Frosthaven/zmk-config-corne-eclipse/README.md

README | [Keymap](KEYMAP.md) | [Parts](PARTS.md) | [Fabrication](FABRICATION.md) | [Building](BUILDING.md) | [Tricks](TRICKS.md)

# Corne Eclipse

Corne Eclipse Front And Back

The Corne Eclipse is a highly customized wireless Corne MX with the following:

- Custom circuit board design
    - JST port with line passthrough for undercarriage battery storage
    - Native support for nice!view displays
    - Native support for dual EC11 encoders
    - Native support for side mounted power switches
    - Native support for tenting puck
- Custom shield casing design (based on Void's case)
    - Undercarriage battery storage
    - Optimized material usage for bottom
    - Native support for tenting puck

*This was a project I finished in 2021. Finally updated and open sourced!*
