Frosthaven/zmk-config-corne-eclipse/assets/images/mac-rebind-modifiers.png

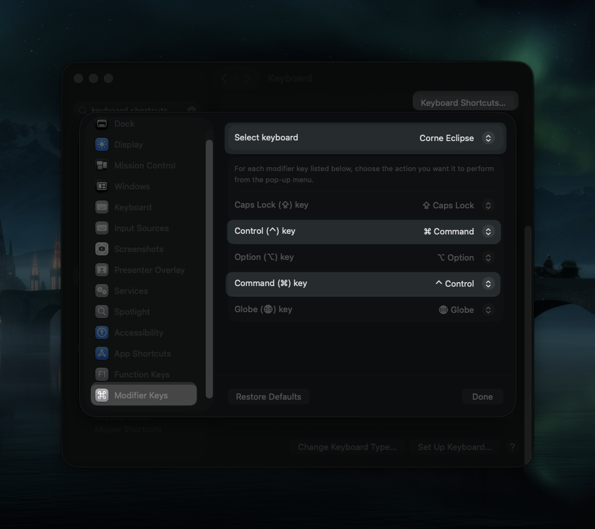
assets/images/mac-rebind-modifiers.png
