Frosthaven/zmk-config-corne-eclipse/fabrication/!for-fabricator-production/corne-eclipse-shield-right.stl

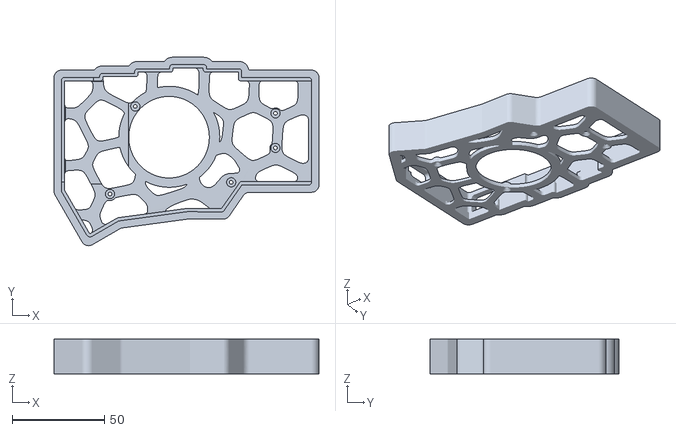
[picture p9: CAD file, 2026-03-28]
fabrication/!for-fabricator-production/corne-eclipse-shield-right.stl
143.7 x 102.3 x 18.9
