Frosthaven/zmk-config-corne-eclipse/(list of files, cad)

Other CAD files:
fabrication/!for-fabricator-production/corne-eclipse-shield-left.stl
