Frosthaven/zmk-config-corne-eclipse/FABRICATION.md

[README](README.md) | [Keymap](KEYMAP.md) | [Parts](PARTS.md) | Fabrication | [Building](BUILDING.md) | [Tricks](TRICKS.md)

# Fabrication

While the [parts](PARTS.md) page covers items you can buy, this page documents
what needs to be created.

The circuit board, plates, and shields need to be fabricated by a PCB and 3D
printing company like [Elecrow](https://www.elecrow.com/),
[JLCPCB](https://jlcpcb.com/), [PCBWay](https://www.pcbway.com/), or
[OSHPark](https://oshpark.com/). I've had good work from Elecrow in the past.

## Circuit Board Fabrication

### Circuit Board

Circuit Board

Some vendors won't render the outside negative space of the circuitboard
correctly in their uploader tool, but it is still fine.

Provide these files to the fabricator:
- [corne-eclipse-circuitboard.zip](/fabrication/!for-fabricator-production/corne-eclipse-circuitboard.zip)

### Plates

Plates

This will need to be cut the same way that circuitboards are. There may be an
extra charge for adding break-away points to the plate print.

Provide these files to the fabricator:
- [corne-eclipse-plates.zip](/fabrication/!for-fabricator-production/corne-eclipse-plates.zip)

## Shield Case Fabrication

Shield

Provide these files to the fabricator:
- [corne-eclipse-shield-left.stl](/fabrication/!for-fabricator-production/corne-eclipse-shield-left.stl)
- [corne-eclipse-shield-right.stl](/fabrication/!for-fabricator-production/corne-eclipse-shield-right.stl)
