Frosthaven/zmk-config-corne-eclipse/BUILDING.md

[README](README.md) | [Keymap](KEYMAP.md) | [Parts](PARTS.md) | [Fabrication](FABRICATION.md) | Building | [Tricks](TRICKS.md)

# Building

Coming Soon
