Frosthaven/zmk-config-corne-eclipse/(commit log)

2026-03-28 Import project
    [corne-eclipse-B_Cu.gbl, corne-eclipse-B_Mask.gbs, corne-eclipse-B_Silkscreen.gbo, corne-eclipse-Edge_Cuts.gm1, corne-eclipse-F_Cu.gtl, corne-eclipse-F_Mask.gts, corne-eclipse-F_Silkscreen.gto, corne-eclipse-NPTH-drl_map.gbr]
2026-03-28 chore: rework NAVPAD layer navigation keys
    Remove cross-platform line start/end macros in favor of plain Home/End
    keys. Reorganize nav cluster: Home/End replace macros, PgUp/PgDn shift
    inward, add PrintScreen/Insert/PauseBreak, swap NumLock/ScrollLock.
2026-03-29 refactor(keymap): reorganize layers 5-7
    - Rename layers: SYMBOL→NAVSYM, NAVPAD→MSENUM
    - Move nav keys to NAVSYM, mouse/media to MSENUM, F-keys to SYSTEM
    - Move brightness controls to SYSTEM layer
    - Add media controls (prev/play/next) to NAVSYM
    - Move middle click below mouse down on MSENUM
2026-05-20 feat(widgets): show ".." on battery cells while settling at boot
2026-05-23 docs(trackpad): note 3V3 as an alias for the VCC/VDD power pad
2026-05-24 feat(trackpad): port updated input-split gesture firmware to main
    Bring the peripheral-trackpad input-split architecture + forked gesture driver
    to main (overlays, dtsi, west.yml driver pin, central-status widgets, scenario
    build variants for all 5 layouts, release workflow, wiring doc). main's old
    USE_TRACKPAD/direct-listener scheme couldn't support a peripheral-side trackpad.
    Fabrication files, keymap, and docs are untouched.
2026-05-24 feat(battery+encoder): reliable 100% charge + finer left encoder
    - Pin zmk to 0f70feb9 (battery LUT 100% anchor 4150->4080mV so a full cell
    reliably reads 100%). SHA-pin busts the CI west-module cache.
    - left_encoder steps 20->80 so one detent = ~1 volume event instead of several.
2026-05-24 revert(encoder): left_encoder steps back to 20
    steps was the wrong lever for volume granularity: the per-event volume step is
    OS-controlled (the keyboard only sends volume up/down). steps=80 just made the
    encoder fire a volume event every ~2-6 clicks (less responsive) without changing
    the step. Back to 20 = one volume event per click. Battery LUT fix stays.
2026-05-25 feat(encoder): right encoder zooms (Ctrl+scroll) on trackpad builds
    Gate the right encoder per build: trackpad firmware (TRACKPAD_PERIPHERAL or
    TRACKPAD_CENTRAL) zooms via Ctrl + mouse-scroll (zoom_in/zoom_out macros driven
    by a zoom_encoder sensor-rotate); plain 'no trackpads' builds keep their prior
    scroll_vertical/scroll_horizontal behavior. Left encoder stays volume.
2026-05-25 fix(encoder): correct right-encoder zoom direction
    CW now zooms in, CCW zooms out (was reversed on hardware). Ashley's fork
    keeps the opposite direction to match its reversed encoder.
2026-05-25 fix(encoder): steps 40 for EC12 (one trigger per detent)
    EC12 encoders have 4 quadrature edges per detent. With steps=20 and
    triggers-per-rotation=10 the driver emitted 2 triggers per detent (one
    mid-click, one at the click). steps=40 makes 4*10/40 = exactly one trigger
    per physical detent. Frosthaven hardware only; Ashley's encoders may differ.
2026-05-25 fix(encoder): EC12 config steps=80, triggers-per-rotation=20
    Alps EC12 = 20 detents / 20 pulses per rotation; the driver counts 4 quadrature
    edges per pulse (80 edges/rotation). One trigger per detent requires
    triggers-per-rotation = detent count (20) so a trigger boundary lands on each
    click, with steps = edge count (80). Previous steps=20/40 with T=10 gave 2x then
    misaligned (every-other) activations. Frosthaven hardware only.
2026-05-25 docs(encoder): note EC12 tuning is active + EC11 values
    Comment-only; document that steps/triggers-per-rotation are tuned for the EC12
    on this board, with the EC11 (2 edges/detent) alternative inline. No firmware
    change.
2026-05-25 fix(encoder): margin-tune EC12 steps to 76 (stop dropped clicks)
    The exact EC12 value (steps=80) placed the trigger boundary exactly on the 18deg
    detent boundary with zero slack, so a detent landing a hair short dropped the
    click (seen on slow single clicks). Run steps ~5% under the edge count (76) so
    each detent clears the threshold with a small surplus; trade is a rare double on
    continuous spinning. Comment documents both exact and margin-tuned EC12/EC11
    values. Frosthaven hardware only.
2026-05-25 fix(encoder): steps=72 (whole-number deg/edge + more margin)
    steps=76 still dropped some detents. 360/76 is fractional (4.73 deg/edge), so the
    sensor math carries a remainder that truncates differently CW vs CCW and can drop
    clicks. steps=72 gives 360/72 = 5 deg/edge exactly (no fractional remainder) and
    20 deg/detent (2 deg over the 18 deg threshold). Trade is a rare double every ~9
    detents on continuous spinning. Frosthaven hardware only.
2026-05-25 fix(encoder): steps=60 (encoder under-fired at 72)
    Measured fire rate at steps=72 was ~76% (CW 17/23, CCW 18/23) -- the EC12
    intermittently reports ~3 edges on some detents, falling short of the 18deg
    threshold. steps=60 (360/60=6deg/edge) makes a 3-edge detent = 18deg (fires) and
    4-edge = 24deg. Edge count is inconsistent so 1:1 is a miss/double trade; this
    biases toward firing. Frosthaven hardware only.
2026-05-25 fix(encoder): steps=64 (balance point between miss/double)
    steps=60 over-fired (1.11/detent: 3 doubles, 1 miss in 18); steps=72 under-fired
    (0.76). The encoder emits inconsistent edges/detent so 1:1 isn't perfectly
    achievable; steps=64 targets the avg~1.0 minimum-error point. Frosthaven only.
2026-05-25 docs(encoder): record steps=64 verified clean 1:1 on hardware
    Comment-only; steps=64 confirmed 20/20 detents both directions. No firmware
    change (build-163 already has steps=64).
2026-05-25 test(encoder): drop GPIO_PULL_UP + steps=80 (zmk#2666 signal fix)
    One EC12 was dropping a quadrature edge per detent (missed clicks). Per zmk#2666,
    the MCU internal pull-up can fight the board's external pull-up/debounce; remove
    | GPIO_PULL_UP on both a/b-gpios and return steps to the exact 80 (EC12 24/24 =
    4 edges/detent x T=20). If the clean signal holds, both encoders hit 1:1 without
    the margin compromise. Restore pull-up flags if an encoder goes dead. Frosthaven
    main only, experimental.
2026-05-25 Revert "test(encoder): drop GPIO_PULL_UP + steps=80 (zmk#2666 signal fix)"
    This reverts commit 3b4a487a33f5f46a47dfe962cd64ef0061fd306f.
2026-05-25 fix(encoder): EC12 exact steps=80 (pull-up retained)
    Use the datasheet-exact EC12 24/24 value (steps=80, triggers-per-rotation=20,
    the zmk#2666 thread's working numbers). Pull-up removal is NOT viable on this
    board (no external pull-up; removing it killed both encoders), so the internal
    | GPIO_PULL_UP stays. Fallback to steps=64 if slow clicks drop. Frosthaven only.
2026-05-25 revert(encoder): drop trackpad-zoom; restore per-layer scroll + EC12 96/24
    The right-encoder Ctrl+scroll zoom (gated on trackpad builds) is removed: the
    encoder's edge jitter made zoom unreliable. Right encoder returns to plain
    scroll_vertical / scroll_horizontal per layer as before (removed the gate,
    zoom_encoder behavior, and zoom_in/out macros).
    Also corrects the EC12 tuning to the datasheet-faithful 24/24 values:
    triggers-per-rotation=24 (detents), steps=96 (4x). Pull-up retained (board has
    no external pull-up). Frosthaven main only.
2026-05-25 feat(encoder): re-add trackpad-gated zoom; main branch = EC11 60/30
    Restore the right-encoder Ctrl+scroll zoom (gated on TRACKPAD_PERIPHERAL/
    TRACKPAD_CENTRAL, all layers; non-trackpad builds keep per-layer scroll).
    Set THIS branch (main) to EC11 30/15 tuning (steps=60, triggers-per-rotation=30);
    v3-choc-mx stays EC12 24/24 (96/24) -- the encoder dtsi now differs by branch.
2026-05-25 docs(parts): M2x8mm standoffs (was M2x4mm) + correct Amazon link
2026-05-27 build(west): bump azoteq driver to 35fac92 (scroll no longer right-clicks)
    The IQS5xx driver now treats any moving two-finger touch as a scroll/zoom
    attempt rather than a tap, so a short two-finger scroll can no longer be
    misclassified as a two-finger tap (right click) on lift.
2026-06-15 build(west): bump cirque + azoteq forks for trackpad PM device support
    Pulls cirque-input-module fork at c9d41b4 (petejohanson's
    feat/idle-waker-wake-from-sleep-fixes cherry-picked) and zmk-driver-azoteq-iqs5xx
    gestures branch at 9c6f2be (new iqs5xx_pm_action). Both drivers now handle
    PM_DEVICE_ACTION_RESUME by re-applying chip config and re-arming their
    data-ready GPIO interrupt -- the trackpad recovers cleanly when the SoC wakes
    from CONFIG_ZMK_SLEEP, no more 'dead until power-cycle' after a long idle.
2026-06-15 feat(trackpad): slow Azoteq cursor 25% via cursor-scale-percent
    Bump azoteq fork to fe0acfd (adds cursor-scale-percent DT prop that scales
    REL_X/REL_Y by a percentage before reporting). Set cursor-scale-percent = <75>
    on the azoteq_tp node in both right and left overlays so the cursor reports
    75% of the chip's raw delta -- 25% slower than before, consistent across hosts.
2026-06-18 feat(trackpad): tap-then-hold drag-lock (replace chip press-and-hold)
    Swap the Azoteq's press-and-hold engagement for tap-then-hold: a
    1-finger tap followed by another single-finger touch-down within
    250ms latches the left button at touch-down -- the drag tracks the
    very first move, no hold-time wait. Multi-finger landings still
    scroll/zoom cleanly; the drag-lock is still released by a tap (or
    a multi-finger tap as a guaranteed escape).
    DT: remove press-and-hold from both overlays, add tap-then-hold.
    west.yml: bump azoteq fork to ddda9f8 (gestures HEAD); includes the
    tap-then-hold engagement plus a fix for the tap-release race where
    the tap's pending 100ms auto-release could fire mid-drag i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
2026-06-18 feat(encoder): right encoder always scrolls (drop trackpad zoom mode)
    The right encoder previously emitted Ctrl+scroll on trackpad builds
    (via the zoom_encoder behavior and zoom_in/zoom_out macros) and
    plain scroll otherwise. With the trackpad's two-finger scroll
    covering the same gesture, the encoder doesn't need to double as a
    zoom wheel -- unify on scroll for all builds.
    Collapse the TRACKPAD_PERIPHERAL/CENTRAL conditional in the keymap;
    remove the now-unused zoom_encoder behavior and the zoom_in /
    zoom_out macros.
2026-06-18 docs(trackpad): describe tap-then-hold drag-lock in WIRING_TRACKPAD
2026-06-18 build(west): bump azoteq to d412c57
    Cursor: per-axis fractional accumulator preserves slow precision
    motion (the integer scale used to round chip deltas of 1 to zero
    at scale<100, leaving a dead zone for granular selection).
    Scroll: cursor-scale-percent now applies to the wheel divisor too
    so the slowdown matches.
    Tap-then-hold: engage window 250ms -> 200ms (feels like a
    deliberate double-touch, not a chance re-tap).
2026-06-18 tune(encoder): scroll val 25 -> 100 per detent
2026-06-18 build(west): bump azoteq to 870a830
    Fixes double-tap eating: tap-then-hold engagement now waits for
    motion before latching LEFT, so a quick second tap lifts cleanly
    through the normal tap path as a second click. emit_click also
    release-firsts a still-held button so fast taps land as two
    distinct clicks.
    Halves the scroll slowdown vs cursor (cursor=50 -> scroll_div=42,
    was 64) so the wheel doesn't feel as heavy as the cursor.
2026-06-18 build(trackpad): disable experimental zoom
    The chip's pinch/expand gesture never triggered reliably on the
    43mm TPS43 (separation barely changes), and at sensitive thresholds
    it stole two-finger scroll. Drop it entirely:
    - west.yml: bump azoteq fork to a5f71c6 (zoom removed from the
    driver and DT binding).
    - left.overlay: remove tp_zoom_in / tp_zoom_out macros and
    tp_zoom_proc processor along with their includes, and drop the
    input-processors = <&tp_zoom_proc>; references from both the
    split listener and the central-local listener.
    - right.overlay: remove the stale /* zoom; -- disabled */ note on
    the azoteq node.
